CCbitcode/MIPS-Pipeline-Processor/README.md

# MIPS-Pipeline-Processor
使用verilog编写，可在xilinx FPGA板上运行的流水线MIPS处理器设计
